rincode-dev/robo-garcom-iot/carcaca/imagens/cabeca_corte.png

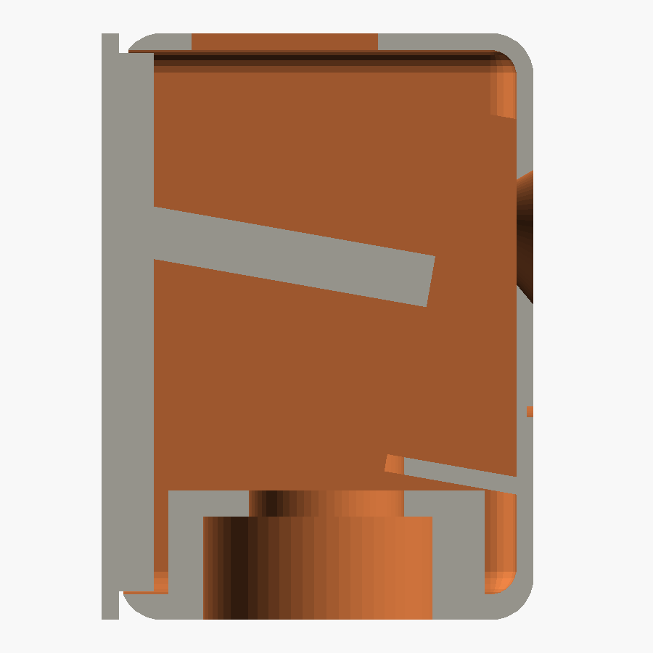
carcaca/imagens/cabeca_corte.png
