rincode-dev/robo-garcom-iot/carcaca/imagens/eletronica_dentro.png

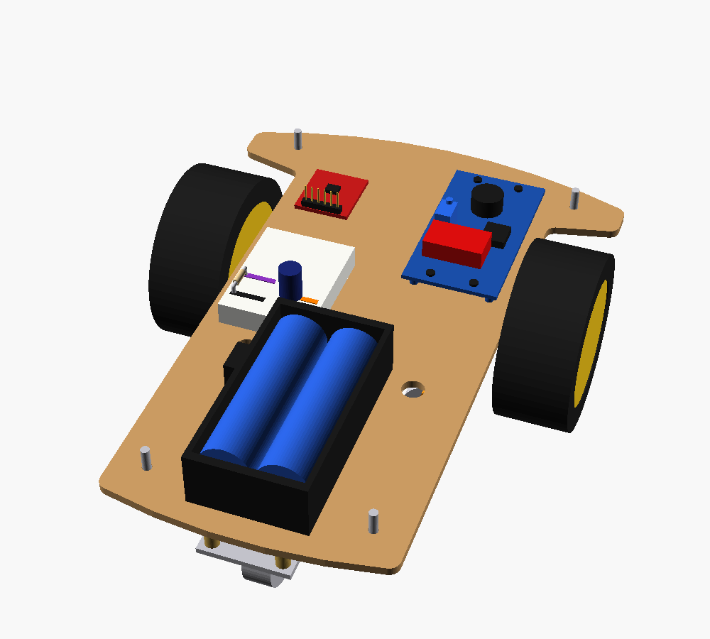
carcaca/imagens/eletronica_dentro.png
