rincode-dev/robo-garcom-iot/carcaca/imagens/perfil.png

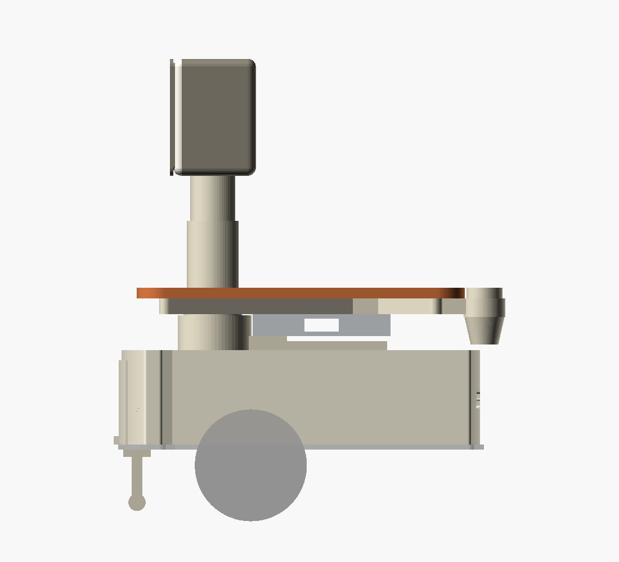
carcaca/imagens/perfil.png
