rincode-dev/robo-garcom-iot/carcaca/imagens/saia_por_baixo.png

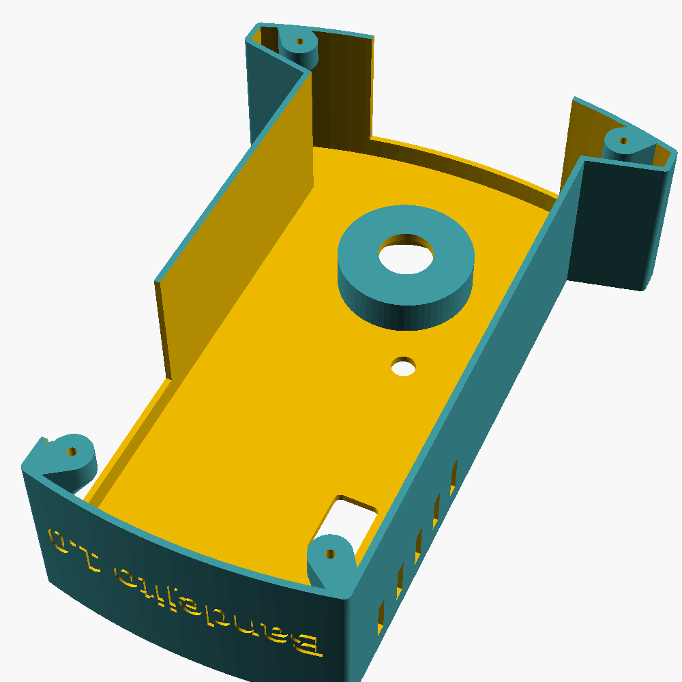
carcaca/imagens/saia_por_baixo.png
