rincode-dev/robo-garcom-iot/carcaca/impressao/0_TODAS_AS_BANDEJAS_so_para_conferir.step

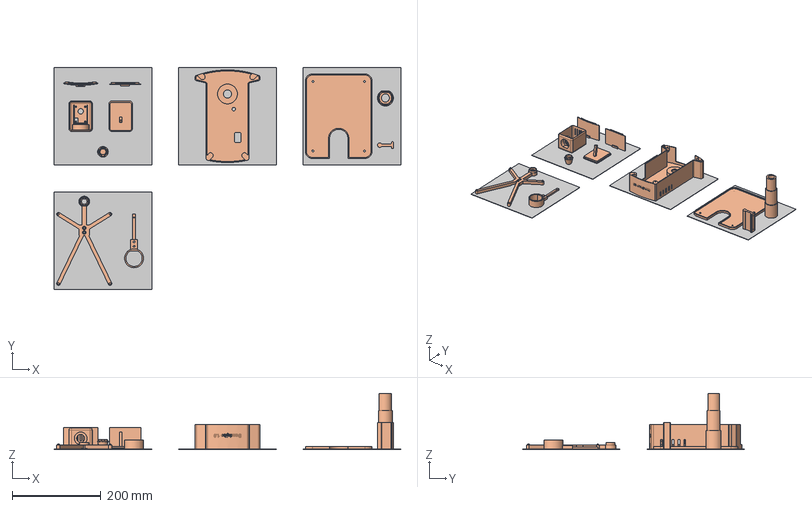
[picture p23: CAD file, 2026-10-17]
carcaca/impressao/0_TODAS_AS_BANDEJAS_so_para_conferir.step
780.0 x 500.0 x 126.0 mm
mesa_da_impressora_REFERENCIA_nao_imprimir x 4
cabeca
cabeca_tampa
tampa_traseira
tampa_lateral
capo_botao
saia
bandeja
coluna
pe_antitombo
aranha
base_balanca
