rincode-dev/robo-garcom-iot/carcaca/step/pe_antitombo.step

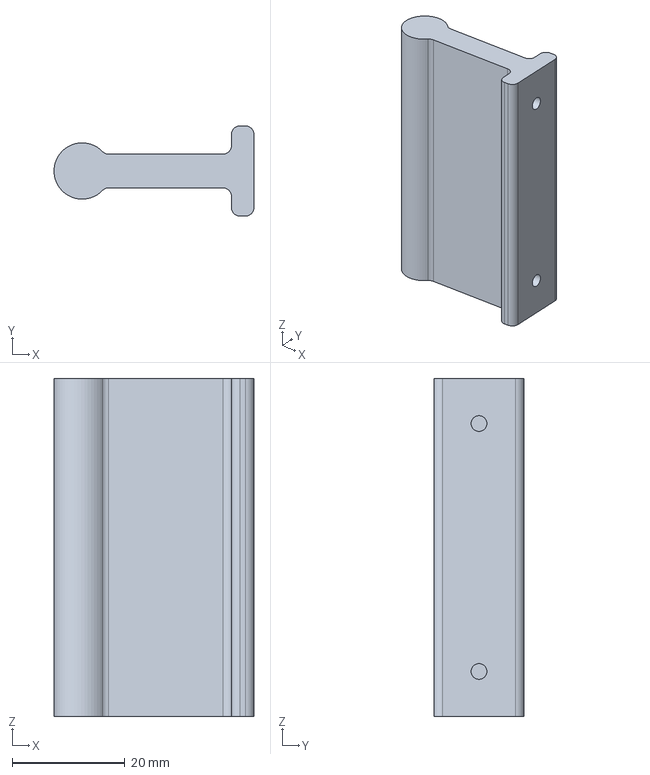
[picture p24: CAD file, 2026-10-17]
carcaca/step/pe_antitombo.step
35.5 x 16.0 x 60.0 mm
