rincode-dev/robo-garcom-iot/maquete/impressao/6_3_assentos_e_1_encosto.step

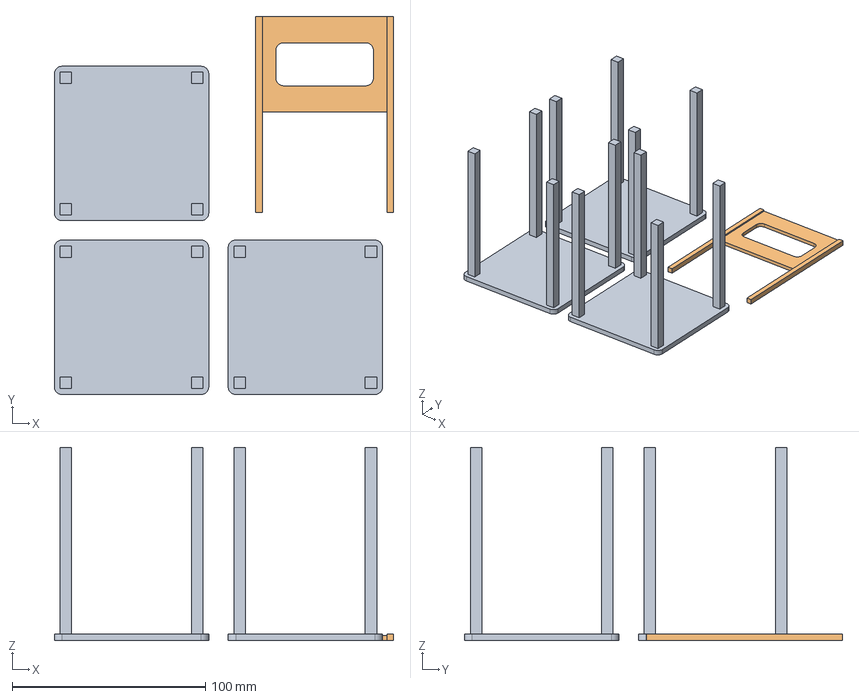
[picture p25: CAD file, 2026-10-16]
maquete/impressao/6_3_assentos_e_1_encosto.step
175.8 x 195.8 x 100.0 mm
assento_4
assento_5
assento_6
encosto_1
