rincode-dev/robo-garcom-iot/maquete/step/maquete_completa.step

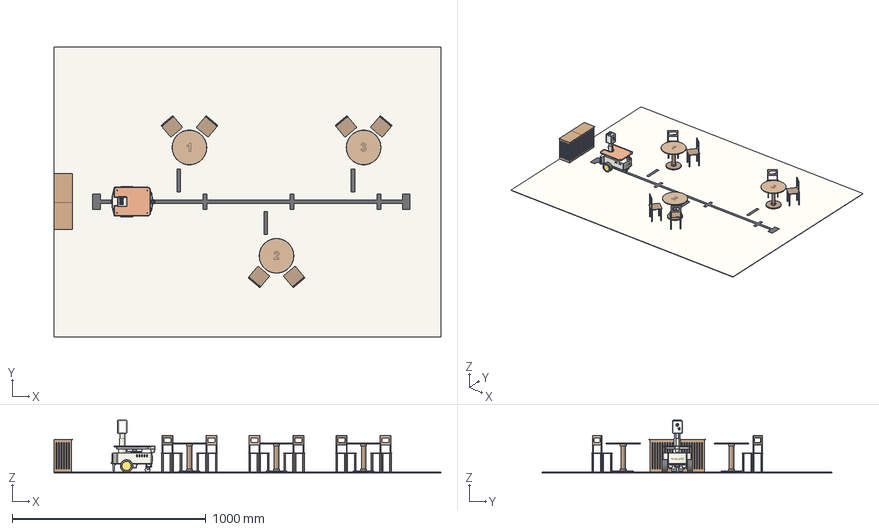
[picture p26: CAD file, 2026-10-17]
maquete/step/maquete_completa.step
2000.0 x 1500.0 x 271.5 mm
tapete
fita
balcao_1
balcao_2
mesa_1_pe
mesa_1_perna
mesa_1_tampo
mesa_1_cadeira_1_assento
mesa_1_cadeira_1_encosto
mesa_1_cadeira_2_assento
mesa_1_cadeira_2_encosto
mesa_2_pe
mesa_2_perna
mesa_2_tampo
mesa_2_cadeira_1_assento
mesa_2_cadeira_1_encosto
mesa_2_cadeira_2_assento
mesa_2_cadeira_2_encosto
mesa_3_pe
mesa_3_perna
mesa_3_tampo
mesa_3_cadeira_1_assento
mesa_3_cadeira_1_encosto
mesa_3_cadeira_2_assento
mesa_3_cadeira_2_encosto
saia
coluna
base_balanca
aranha
capo_botao
pe_antitombo
tampa_traseira
tampa_lateral
bandeja
cabeca
cabeca_tampa
chassi_base
parafusos_M3
motores_caixa_reducao
motores_metal
capacitores_100nF_motores
rodas_pneu
rodas_cubo
roda_boba
roda_boba_espacadores
suporte_2x18650_com_chave
baterias_18650
LM2596_placa
LM2596_componentes
LM2596_display_5V
LM2596_trimpot
protoboard
capacitor_470uF_pernas
capacitor_470uF
protoboard_trilha_vermelho
protoboard_trilha_preto
protoboard_trilha_laranja
protoboard_trilha_roxo
MX1508_placa
MX1508_chip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
