rincode-dev/robo-garcom-iot/carcaca/impressao/1_cabeca_e_tampa_TESTE.step

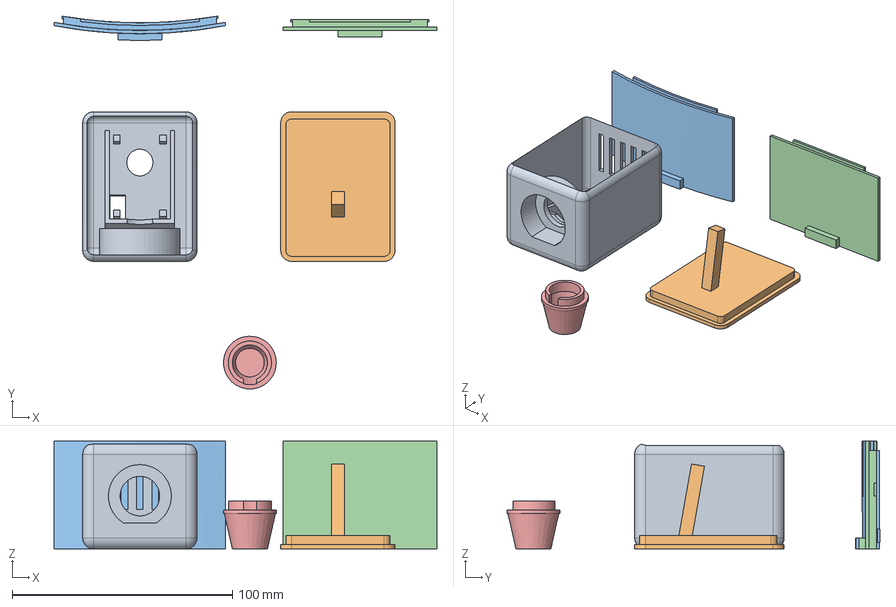
[picture p27: CAD file, 2026-10-17]
carcaca/impressao/1_cabeca_e_tampa_TESTE.step
174.0 x 169.5 x 49.0 mm
cabeca
cabeca_tampa
tampa_traseira
tampa_lateral
capo_botao
