rincode-dev/robo-garcom-iot/carcaca/step/montagem.step

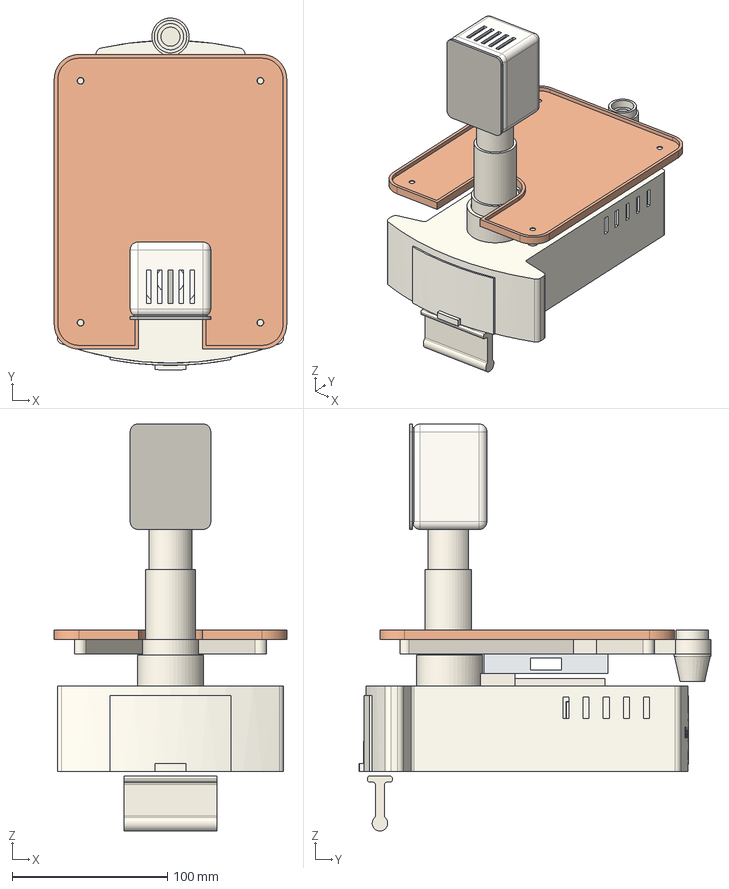
[picture p28: CAD file, 2026-10-17]
carcaca/step/montagem.step
150.0 x 227.0 x 262.5 mm
saia
coluna
bandeja
base_balanca
aranha
cabeca
cabeca_tampa
capo_botao
pe_antitombo
tampa_traseira
tampa_lateral
celula_de_carga_500g_COMPRADA
