rincode-dev/robo-garcom-iot/maquete/impressao/1_tampo_mesa_1.step

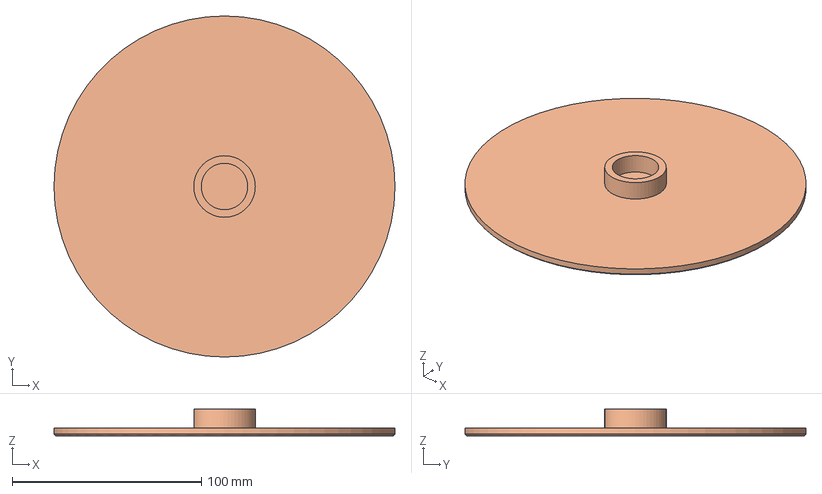
[picture p29: CAD file, 2026-10-16]
maquete/impressao/1_tampo_mesa_1.step
180.0 x 180.0 x 14.0 mm
