rincode-dev/robo-garcom-iot/maquete/step/cadeira_encosto.step

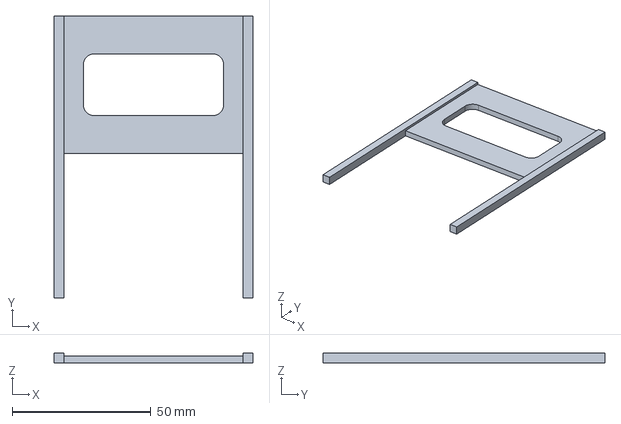
[picture p30: CAD file, 2026-10-16]
maquete/step/cadeira_encosto.step
71.5 x 101.5 x 3.50 mm
