rincode-dev/robo-garcom-iot/carcaca/impressao/2_saia.step

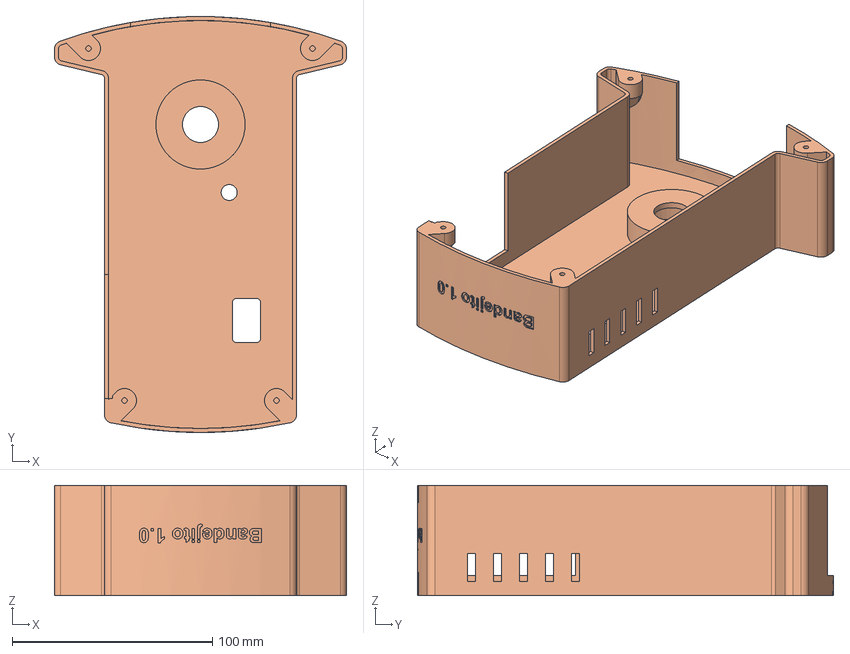
[picture p31: CAD file, 2026-10-17]
carcaca/impressao/2_saia.step
146.0 x 208.0 x 55.0 mm
