rincode-dev/robo-garcom-iot/carcaca/step/bandeja.step

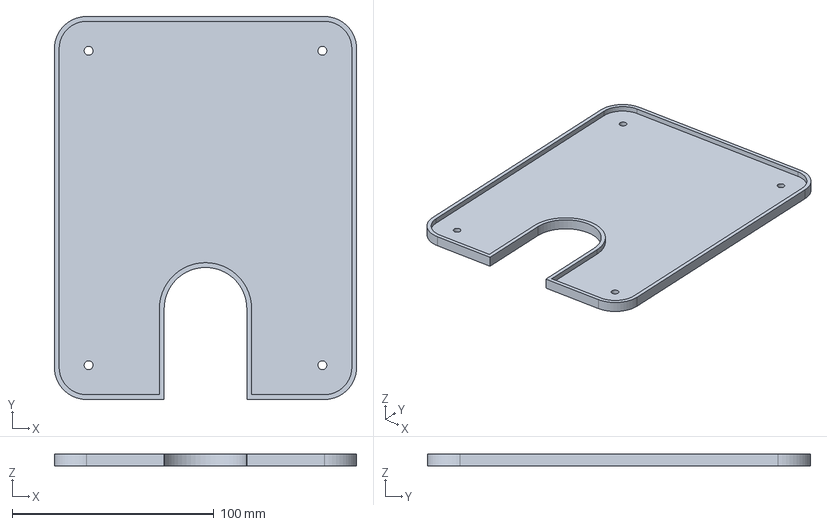
[picture p32: CAD file, 2026-10-17]
carcaca/step/bandeja.step
150.0 x 190.0 x 6.00 mm
