rincode-dev/robo-garcom-iot/maquete/impressao/5_1_pe_e_3_assentos.step

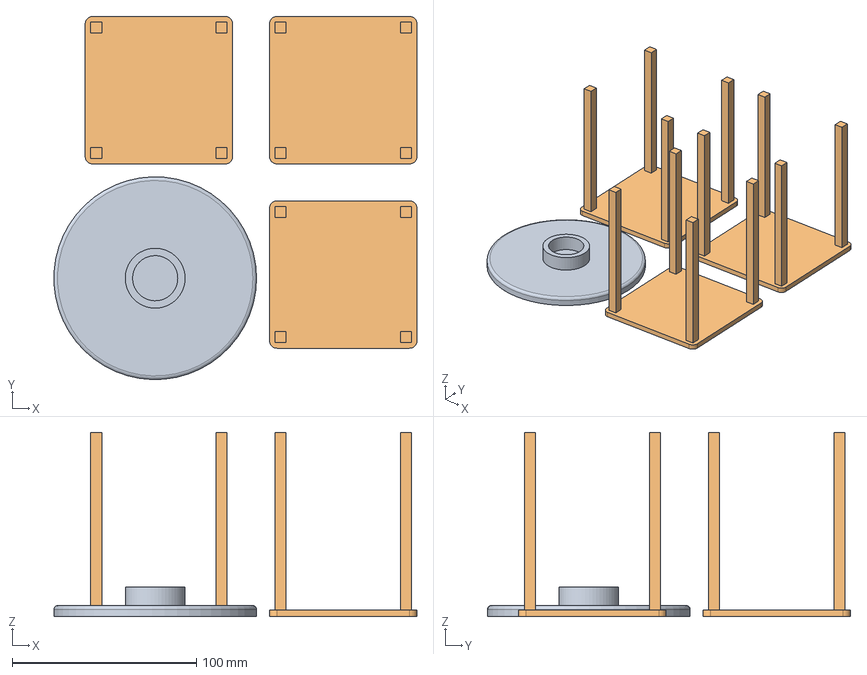
[picture p33: CAD file, 2026-10-16]
maquete/impressao/5_1_pe_e_3_assentos.step
196.9 x 197.0 x 100.0 mm
pe_3
assento_1
assento_2
assento_3
