rincode-dev/robo-garcom-iot/maquete/step/cadeira_assento.step

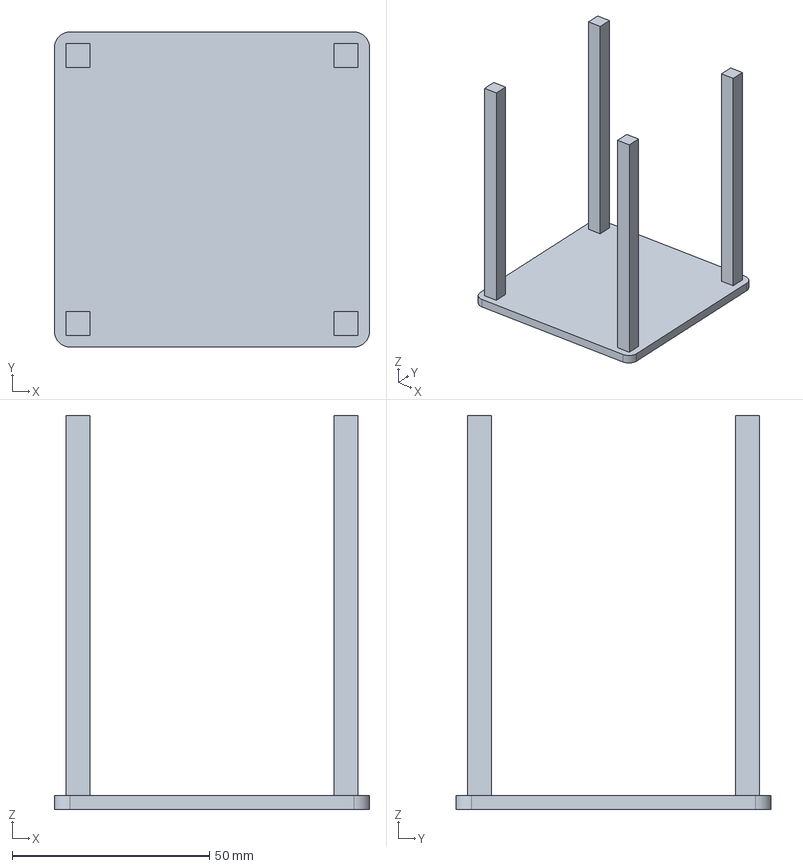
[picture p34: CAD file, 2026-10-16]
maquete/step/cadeira_assento.step
80.0 x 80.0 x 100.0 mm
