rincode-dev/robo-garcom-iot/carcaca/impressao/3_bandeja_coluna_e_pe.step

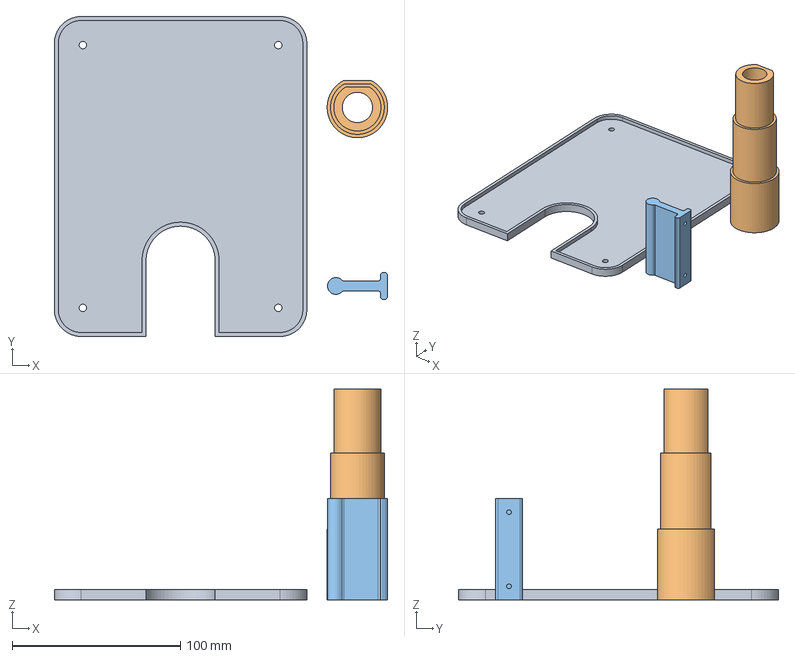
[picture p35: CAD file, 2026-10-17]
carcaca/impressao/3_bandeja_coluna_e_pe.step
198.0 x 190.0 x 125.0 mm
bandeja
coluna
pe_antitombo
