rincode-dev/robo-garcom-iot/carcaca/step/prototipo_completo.step

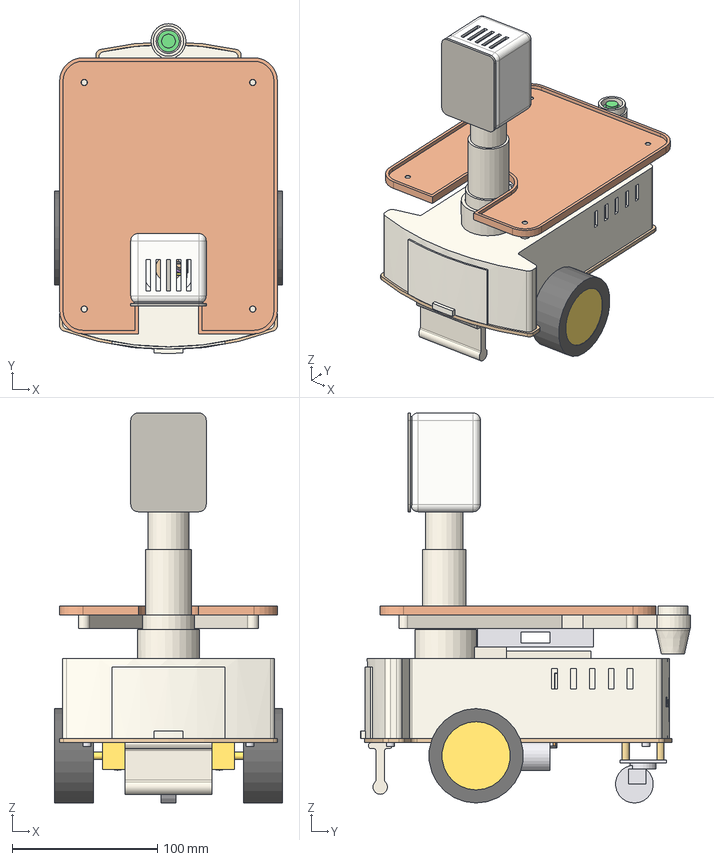
[picture p36: CAD file, 2026-10-17]
carcaca/step/prototipo_completo.step
157.0 x 227.0 x 268.5 mm
saia
coluna
base_balanca
aranha
capo_botao
pe_antitombo
tampa_traseira
tampa_lateral
bandeja
cabeca
cabeca_tampa
chassi_base
parafusos_M3
motores_caixa_reducao
motores_metal
capacitores_100nF_motores
rodas_pneu
rodas_cubo
roda_boba
roda_boba_espacadores
suporte_2x18650_com_chave
baterias_18650
LM2596_placa
LM2596_componentes
LM2596_display_5V
LM2596_trimpot
protoboard
capacitor_470uF_pernas
capacitor_470uF
protoboard_trilha_vermelho
protoboard_trilha_preto
protoboard_trilha_laranja
protoboard_trilha_roxo
MX1508_placa
MX1508_chip
MX1508_barra_pinos
MX1508_pinos
resistor_10k_pernas
resistor_10k
ESP32CAM_placa
ESP32CAM_camera
ESP32CAM_blindagem
ESP32CAM_flash
ESP32CAM_barras_pinos
ESP32CAM_pinos
fio_01_bateria_mais_linha1
fio_02_bateria_menos_linha3
fio_03_lm_IN_mais_linha1
fio_04_lm_IN_menos_linha3
fio_05_lm_OUT_mais_5V_linha5
fio_06_lm_OUT_menos_linha3
fio_07_ponte_GND_3e_3f
fio_08_driver_mais_linha1
fio_09_driver_menos_linha3
fio_10_driver_IN4_linha7
fio_11_motor_esquerdo_a_saida_A
fio_11_motor_esquerdo_b_saida_A
fio_11_motor_direito_a_saida_B
fio_11_motor_direito_b_saida_B
fio_12_esp_5V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
