rincode-dev/robo-garcom-iot/carcaca/impressao/4_aranha_e_base_da_balanca.step

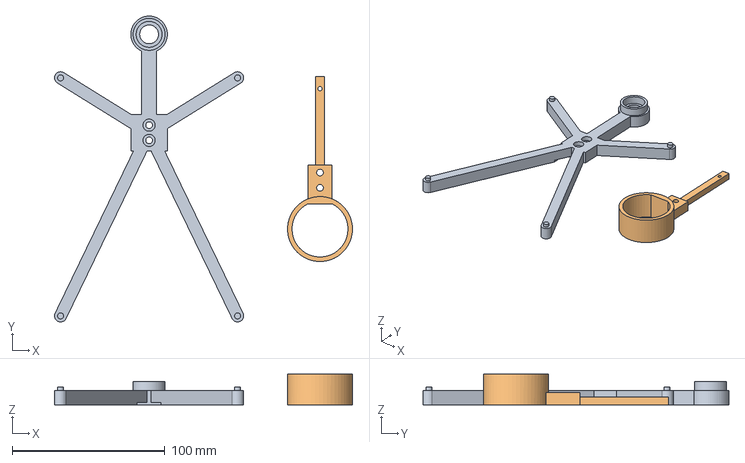
[picture p37: CAD file, 2026-10-17]
carcaca/impressao/4_aranha_e_base_da_balanca.step
195.3 x 200.5 x 20.0 mm
aranha
base_balanca
