rincode-dev/robo-garcom-iot/carcaca/step/coluna.step

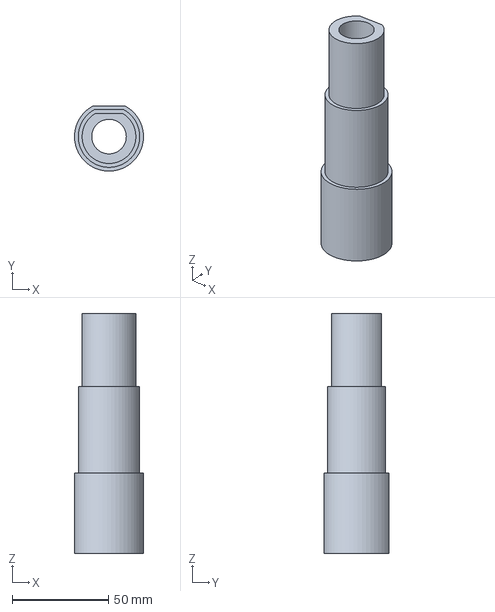
[picture p38: CAD file, 2026-10-17]
carcaca/step/coluna.step
36.0 x 34.0 x 125.0 mm
