rincode-dev/robo-garcom-iot/maquete/impressao/7_4_encostos.step

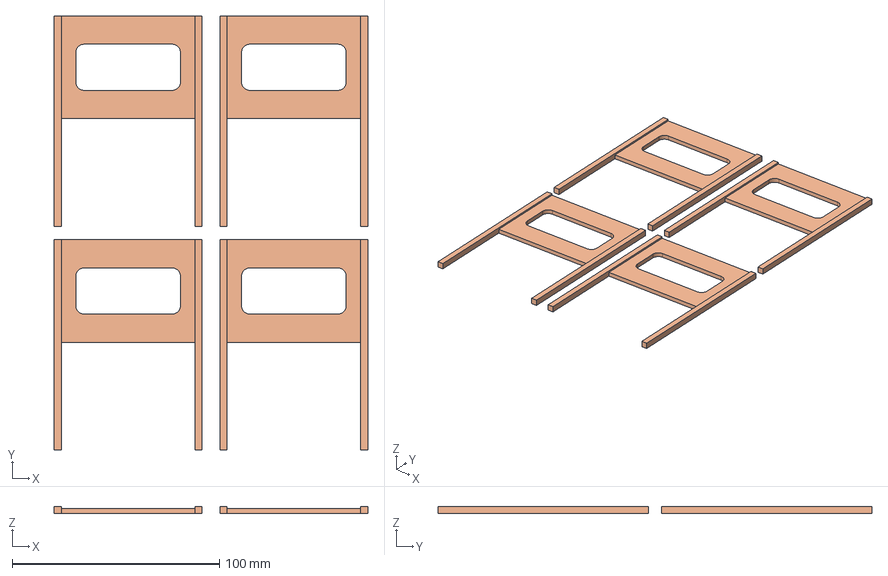
[picture p39: CAD file, 2026-10-16]
maquete/impressao/7_4_encostos.step
151.5 x 209.5 x 3.50 mm
encosto_2
encosto_3
encosto_4
encosto_5
