rincode-dev/robo-garcom-iot/maquete/step/pe.step

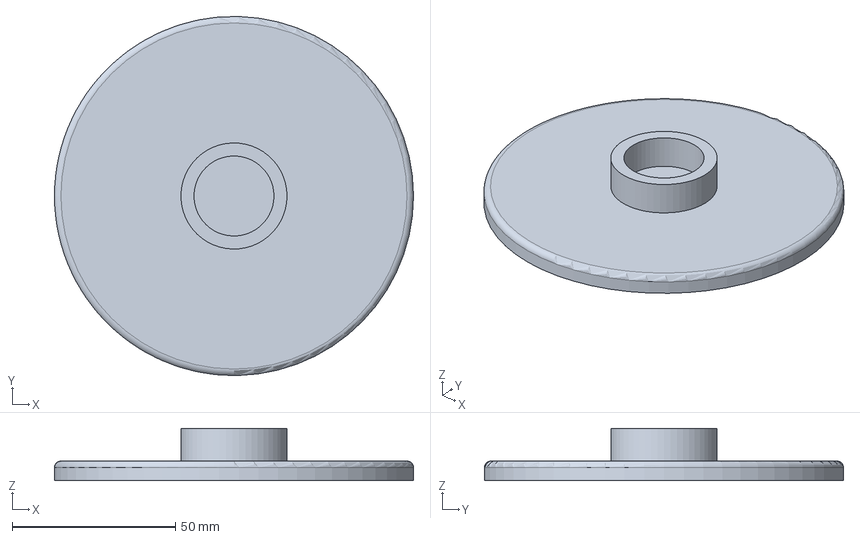
[picture p40: CAD file, 2026-10-16]
maquete/step/pe.step
110.0 x 110.0 x 16.0 mm
