rincode-dev/robo-garcom-iot/carcaca/step/cabeca.step

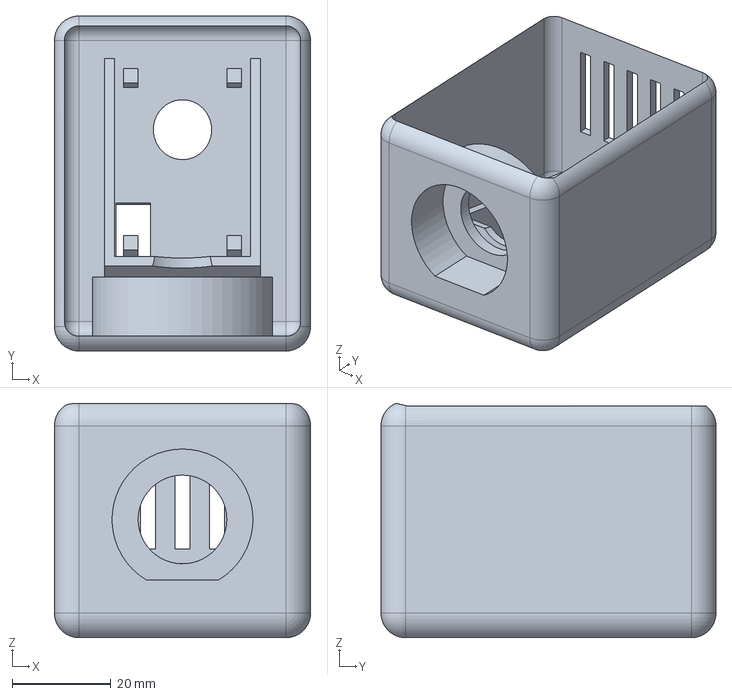
[picture p41: CAD file, 2026-10-17]
carcaca/step/cabeca.step
52.0 x 68.0 x 47.6 mm
