rincode-dev/robo-garcom-iot/maquete/impressao/0_TODAS_AS_BANDEJAS_so_para_conferir.step

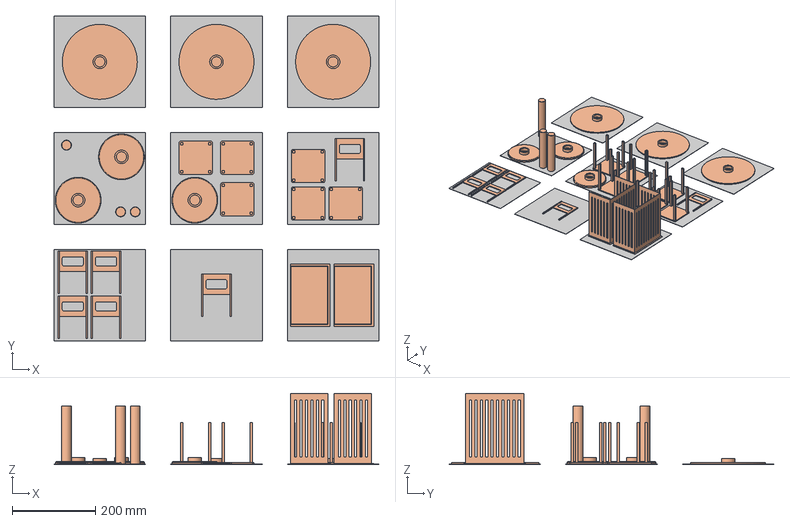
[picture p42: CAD file, 2026-10-16]
maquete/impressao/0_TODAS_AS_BANDEJAS_so_para_conferir.step
780.0 x 780.0 x 171.0 mm
mesa_da_impressora_REFERENCIA_nao_imprimir x 9
tampo_mesa_1
tampo_mesa_2
tampo_mesa_3
pe_1
pe_2
perna_1
perna_2
perna_3
pe_3
assento_1
assento_2
assento_3
assento_4
assento_5
assento_6
encosto_1
encosto_2
encosto_3
encosto_4
encosto_5
encosto_6
balcao_1
balcao_2
