rincode-dev/robo-garcom-iot/carcaca/step/cabeca_tampa.step

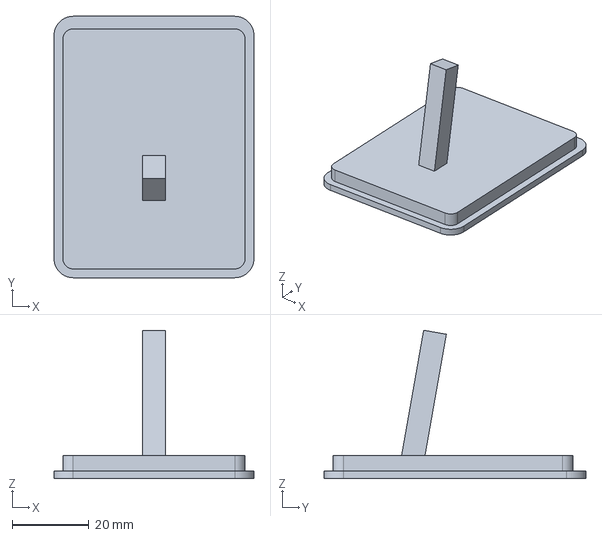
[picture p43: CAD file, 2026-10-17]
carcaca/step/cabeca_tampa.step
52.0 x 68.0 x 38.6 mm
