rincode-dev/robo-garcom-iot/maquete/step/balcao_modulo.step

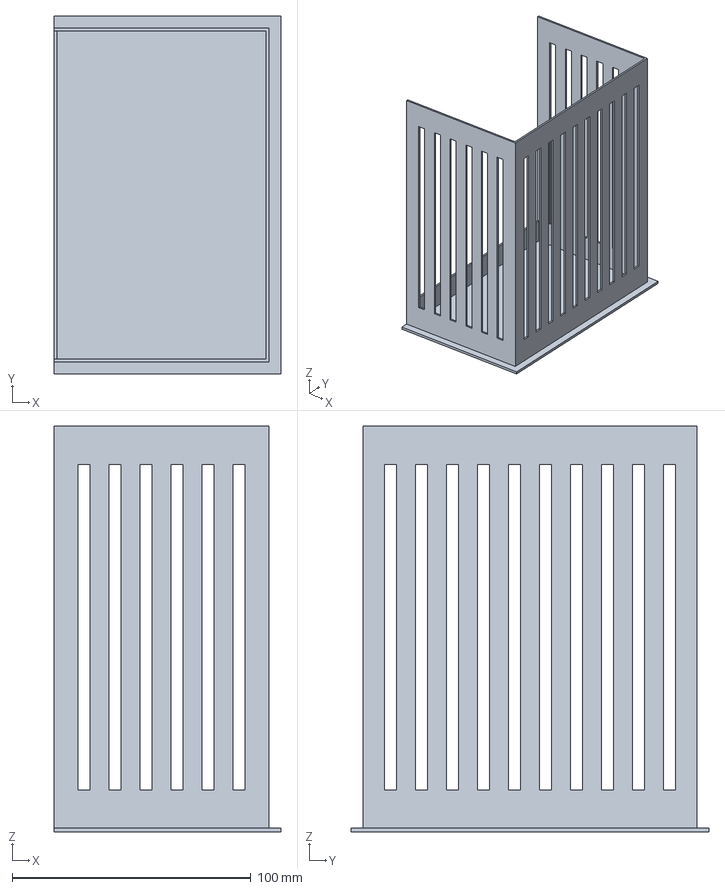
[picture p44: CAD file, 2026-10-16]
maquete/step/balcao_modulo.step
95.0 x 150.0 x 170.0 mm
