rincode-dev/robo-garcom-iot/carcaca/step/aranha.step

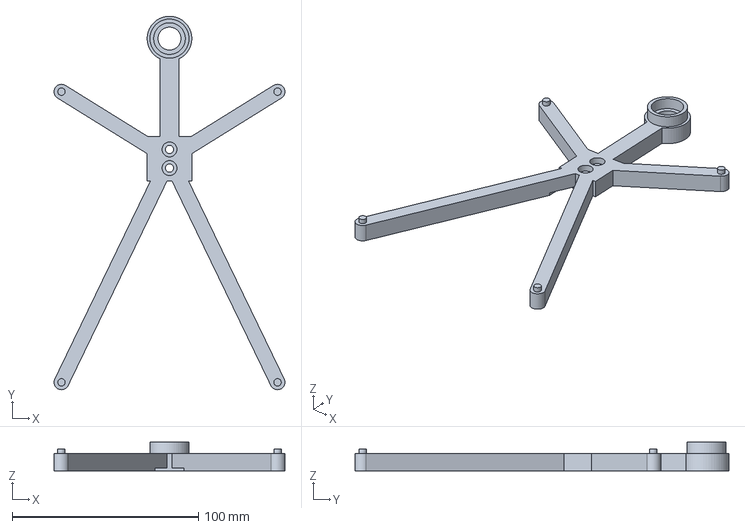
[picture p45: CAD file, 2026-10-17]
carcaca/step/aranha.step
124.0 x 200.5 x 15.3 mm
