rincode-dev/robo-garcom-iot/carcaca/step/capo_botao.step

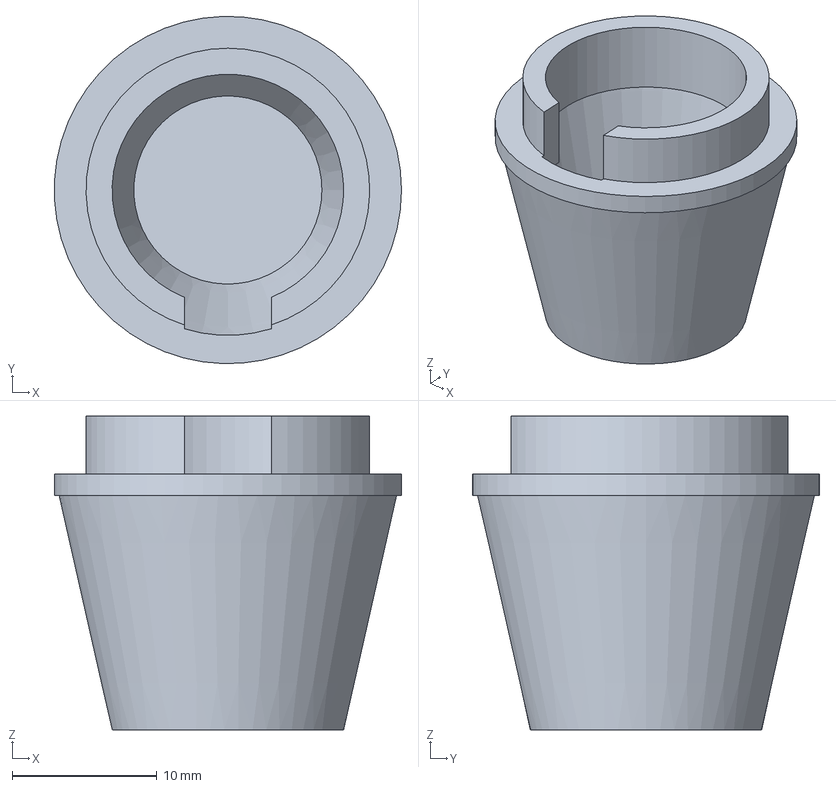
[picture p46: CAD file, 2026-10-17]
carcaca/step/capo_botao.step
24.0 x 24.0 x 21.7 mm
