rincode-dev/robo-garcom-iot/maquete/impressao/9_balcao_2_modulos.step

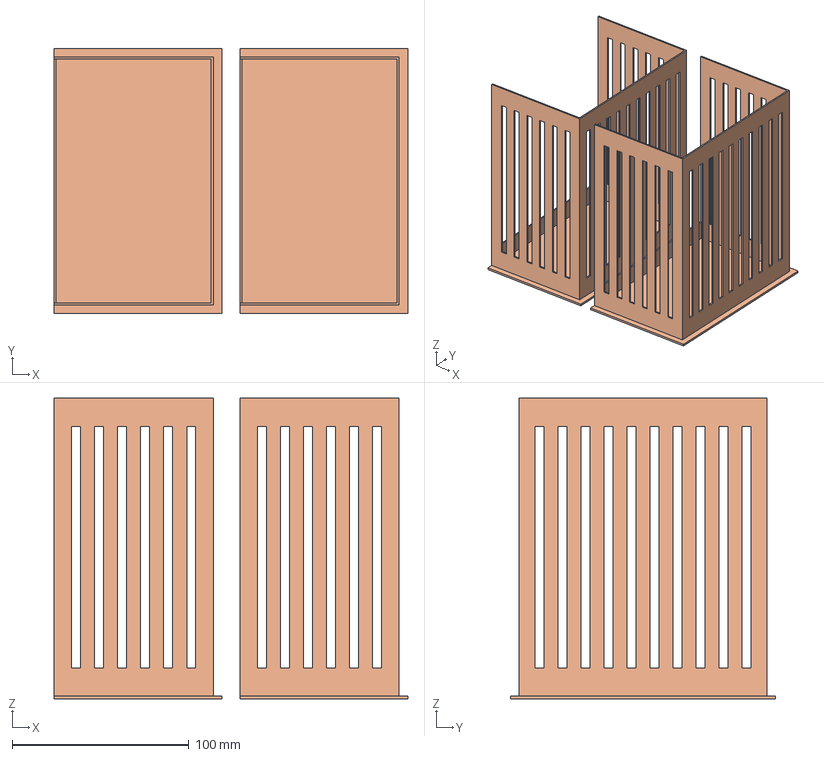
[picture p47: CAD file, 2026-10-16]
maquete/impressao/9_balcao_2_modulos.step
200.0 x 150.0 x 170.0 mm
balcao_1
balcao_2
