rincode-dev/robo-garcom-iot/maquete/step/perna.step

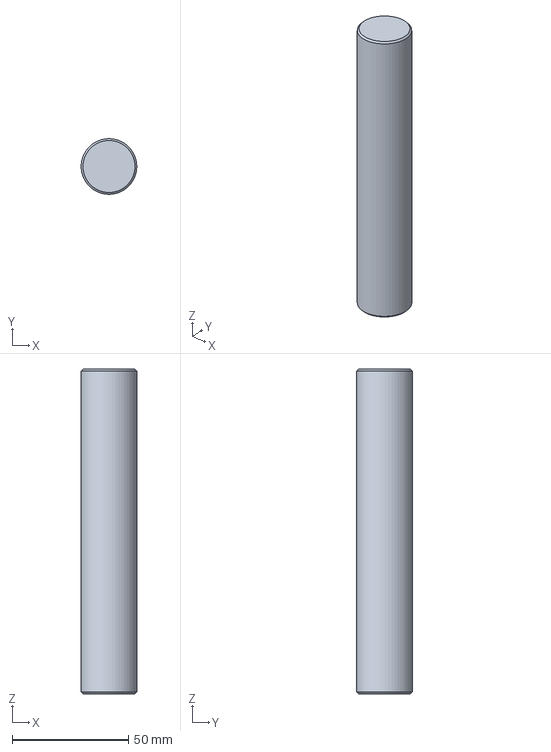
[picture p48: CAD file, 2026-10-16]
maquete/step/perna.step
24.0 x 24.0 x 140.0 mm
