rincode-dev/robo-garcom-iot/carcaca/step/tampa_traseira.step

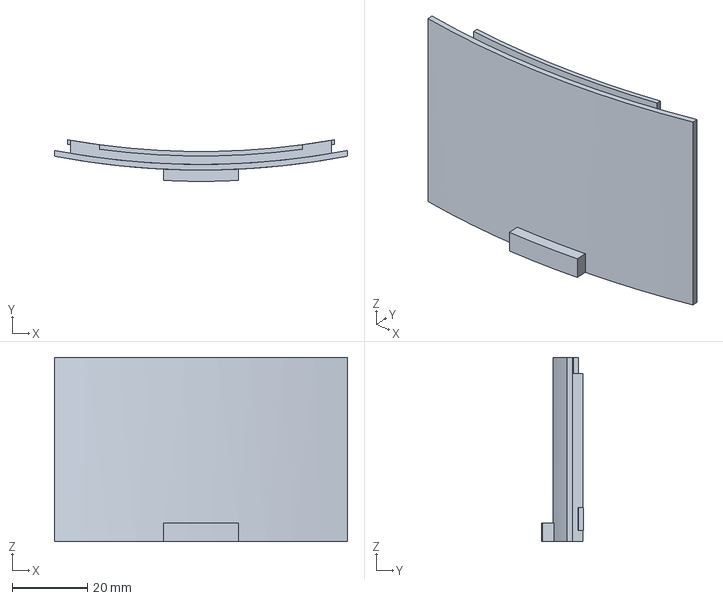
[picture p49: CAD file, 2026-10-17]
carcaca/step/tampa_traseira.step
78.0 x 11.1 x 49.0 mm
