rincode-dev/robo-garcom-iot/maquete/impressao/4_2_pes_e_3_pernas.step

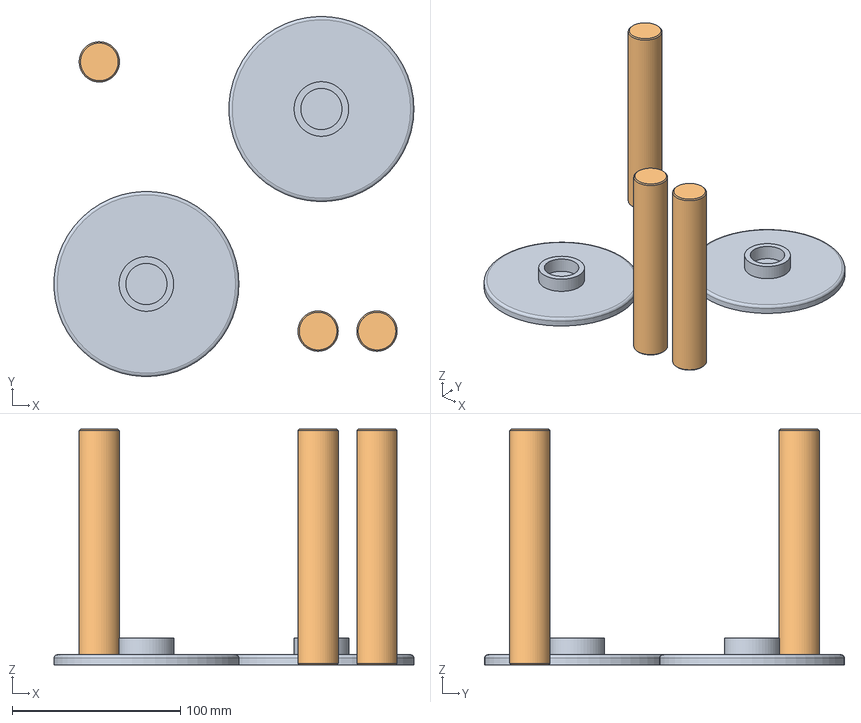
[picture p50: CAD file, 2026-10-16]
maquete/impressao/4_2_pes_e_3_pernas.step
213.9 x 213.9 x 140.0 mm
pe_1
pe_2
perna_1
perna_2
perna_3
