rincode-dev/robo-garcom-iot/carcaca/step/tampa_lateral.step

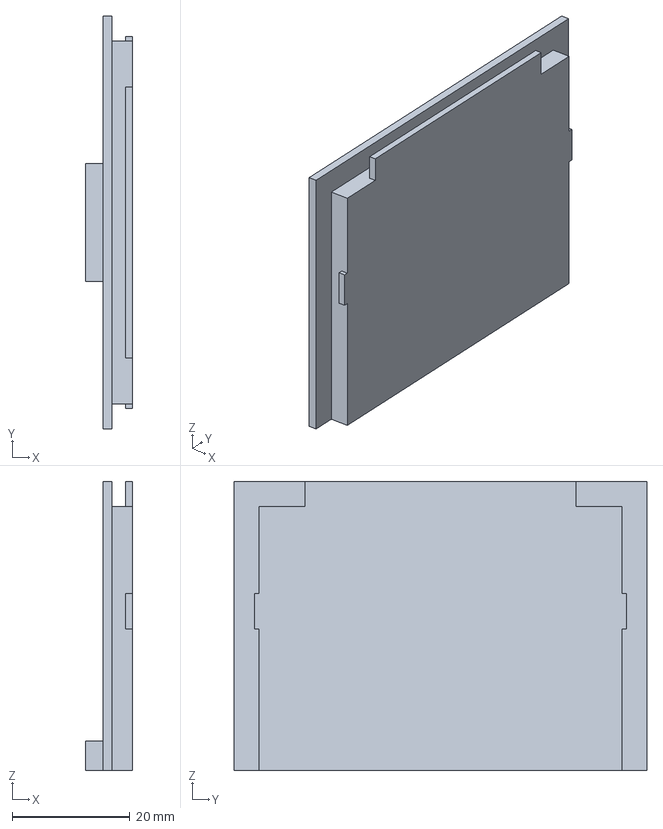
[picture p51: CAD file, 2026-10-17]
carcaca/step/tampa_lateral.step
7.95 x 70.0 x 49.0 mm
