rincode-dev/robo-garcom-iot/carcaca/step/base_balanca.step

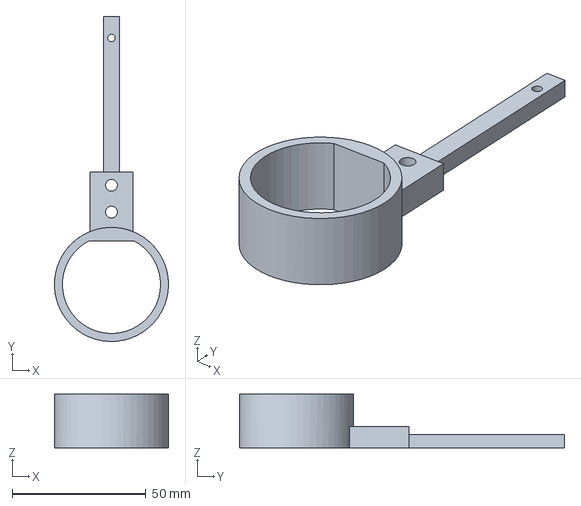
[picture p52: CAD file, 2026-10-17]
carcaca/step/base_balanca.step
42.6 x 121.3 x 20.0 mm
