rincode-dev/robo-garcom-iot/(list of files, cad)

Other CAD files:
maquete/impressao/8_1_encosto.step
maquete/step/tampo_mesa_2.step
maquete/step/tampo_mesa_1.step
maquete/impressao/3_tampo_mesa_3.step
maquete/impressao/2_tampo_mesa_2.step
maquete/step/tampo_mesa_3.step
carcaca/step/saia.step
carcaca/impressao/1_cabeca_e_tampa_TESTE.3mf
carcaca/impressao/1_cabeca_e_tampa_TESTE.stl
carcaca/impressao/2_saia.3mf
carcaca/impressao/2_saia.stl
carcaca/impressao/3_bandeja_coluna_e_pe.3mf
carcaca/impressao/3_bandeja_coluna_e_pe.stl
carcaca/impressao/4_aranha_e_base_da_balanca.3mf
carcaca/impressao/4_aranha_e_base_da_balanca.stl
carcaca/stl/aranha.stl
carcaca/stl/bandeja.stl
carcaca/stl/base_balanca.stl
carcaca/stl/cabeca.stl
carcaca/stl/cabeca_tampa.stl
carcaca/stl/capo_botao.stl
carcaca/stl/coluna.stl
carcaca/stl/pe_antitombo.stl
carcaca/stl/saia.stl
carcaca/stl/tampa_lateral.stl
carcaca/stl/tampa_traseira.stl
maquete/impressao/1_tampo_mesa_1.3mf
maquete/impressao/1_tampo_mesa_1.stl
maquete/impressao/2_tampo_mesa_2.3mf
maquete/impressao/2_tampo_mesa_2.stl
maquete/impressao/3_tampo_mesa_3.3mf
maquete/impressao/3_tampo_mesa_3.stl
maquete/impressao/4_2_pes_e_3_pernas.3mf
maquete/impressao/4_2_pes_e_3_pernas.stl
maquete/impressao/5_1_pe_e_3_assentos.3mf
maquete/impressao/5_1_pe_e_3_assentos.stl
maquete/impressao/6_3_assentos_e_1_encosto.3mf
maquete/impressao/6_3_assentos_e_1_encosto.stl
maquete/impressao/7_4_encostos.3mf
maquete/impressao/7_4_encostos.stl
maquete/impressao/8_1_encosto.3mf
maquete/impressao/8_1_encosto.stl
maquete/impressao/9_balcao_2_modulos.3mf
maquete/impressao/9_balcao_2_modulos.stl
maquete/stl/balcao_modulo.stl
maquete/stl/cadeira_assento.stl
maquete/stl/cadeira_encosto.stl
maquete/stl/pe.stl
maquete/stl/perna.stl
maquete/stl/tampo_mesa_1.stl
maquete/stl/tampo_mesa_2.stl
maquete/stl/tampo_mesa_3.stl
