rincode-dev/robo-garcom-iot/carcaca/imagens/montagem.png

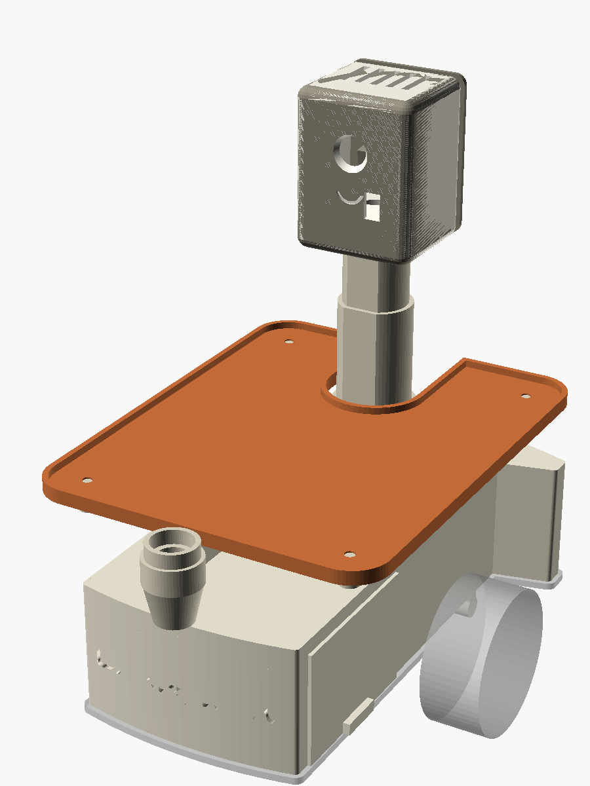
carcaca/imagens/montagem.png
