rincode-dev/robo-garcom-iot/(commit log)

2026-10-14 Bandejito 1.0: firmware, simulador, carcaça 3D e documentação
    [bandeja_baixo.step, bandeja_baixo.stl, bandeja_cima.step, bandeja_cima.stl, cabeca.step, cabeca.stl, cabeca_tampa.step, cabeca_tampa.stl]
2026-10-14 Fase 5: pista em linha reta com meia-volta na mesa e no balcão
2026-10-14 README: GIF do teste completo (obstáculo, entrega, meia-volta, volta)
2026-10-14 Carcaça adaptada à base real do kit (corpo 10 cm + leque 15 cm), rodízio giratório, imagens e GIFs novos
    [bandeja_baixo.step, bandeja_cima.step, cabeca.step, cabeca_tampa.step, coluna.step, montagem.step, prototipo_completo.step, robo_garcom_carcaca.scad]
2026-10-16 Carcaça v2 (coluna recuada, pilhas na frente, pé antitombo, portinhas), partida suave, ramal com voz e botão verde, maquete e lista da Fase 5
    - carcaca_v2_coluna_recuada/: versão 2 em teste (+71% de área livre na
    bandeja de baixo, o dobro na de cima), com comparações e validação.
    - Firmware e simulador: partida suave (MOTOR_RAMP_MS).
    - Simulador: giro de 90 graus até o ramal da mesa, mensagem de voz e
    botão verde.
    - maquete/: mesas, cadeiras e balcão para imprimir; bandejas .3mf.
    - README com o GIF novo do modelo 3D; lista de compras da Fase 5.
    [0_TODAS_AS_BANDEJAS_so_para_conferir.step, 1_cabeca_e_tampa_TESTE.3mf, 1_cabeca_e_tampa_TESTE.step, 1_cabeca_e_tampa_TESTE.stl, 1_tampo_mesa_1.3mf, 1_tampo_mesa_1.step, 1_tampo_mesa_1.stl, 2_saia.3mf]
2026-10-16 Carcaça com coluna recuada vira a versão oficial
    - A primeira versão (coluna no centro) sai do projeto; carcaca/ agora é a
    versão com coluna recuada, pilhas na frente, pé antitombo e portinhas.
    - Imagens da carcaça refeitas com o modelo oficial; maquete gerada de novo
    com o robô oficial e a vista em ângulo com os ramais.
    - Manual de montagem: onde fica cada peça (Etapa 8.6) e os furos dos fios
    dos motores (Etapa 4). README, lista de compras e guia atualizados.
    [0_TODAS_AS_BANDEJAS_so_para_conferir.step, 1_cabeca_e_tampa_TESTE.3mf, 1_cabeca_e_tampa_TESTE.step, 1_cabeca_e_tampa_TESTE.stl, 1_tampo_mesa_1.3mf, 1_tampo_mesa_1.step, 2_saia.3mf, 2_saia.step]
2026-10-16 GIF do percurso na maquete refeito com o robô atual (ramais, giro de 90° até a mesa, botão verde)
2026-10-17 Uma bandeja sobre balança (célula de carga de 500 g) e botão verde no nariz
    A carcaça passa a ter uma bandeja grande solta em cima de um suporte em X
    (a "aranha"), parafusado numa célula de carga: o robô percebe pela balança
    quando o cliente retira o pedido. Botão verde de reserva no nariz da frente,
    com os fios escondidos. Peças, bandejas de impressão, imagens, GIFs, guia,
    manual e lista de compras (com links de busca) atualizados. A versão de
    2 bandejas e as comparações antigas saem do projeto.
    [0_TODAS_AS_BANDEJAS_so_para_conferir.step, 1_cabeca_e_tampa_TESTE.3mf, 1_cabeca_e_tampa_TESTE.step, 1_cabeca_e_tampa_TESTE.stl, 2_saia.3mf, 2_saia.step, 2_saia.stl, 3_bandeja_baixo_coluna_e_pe.3mf]
